markalvincadangin/smart-water-pump-controller/assets/smartflow-architecture-diagram.png

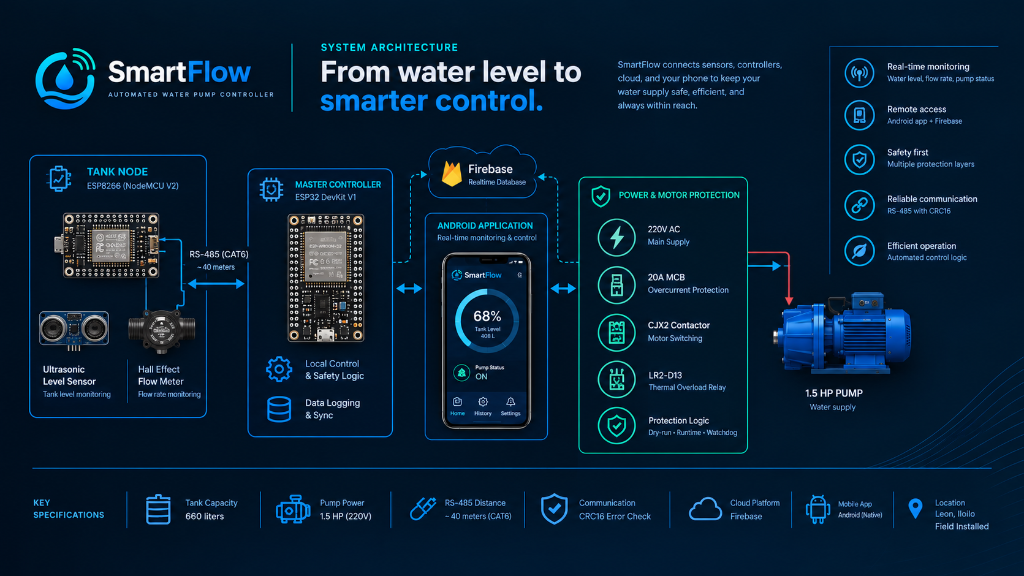
assets/smartflow-architecture-diagram.png
