markalvincadangin/smart-water-pump-controller/assets/smartflow-brandmark.png

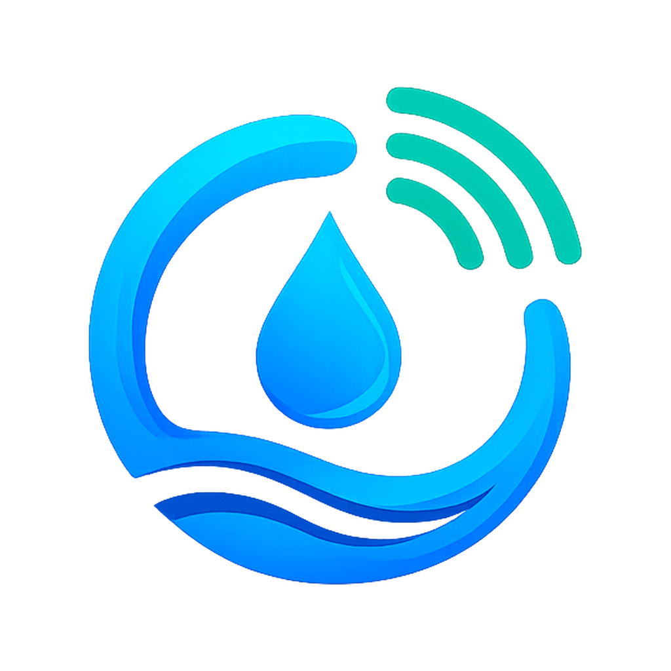
assets/smartflow-brandmark.png
