markalvincadangin/smart-water-pump-controller/assets/smartflow-hero-conceptual.jpg

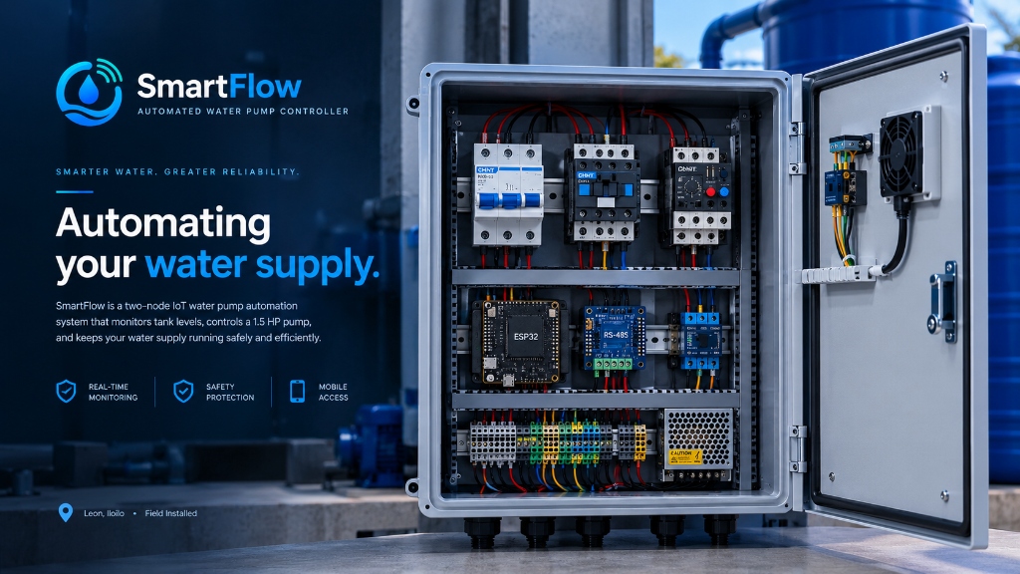
assets/smartflow-hero-conceptual.jpg
