markalvincadangin/smart-water-pump-controller/assets/smartflow-lockup-light.png

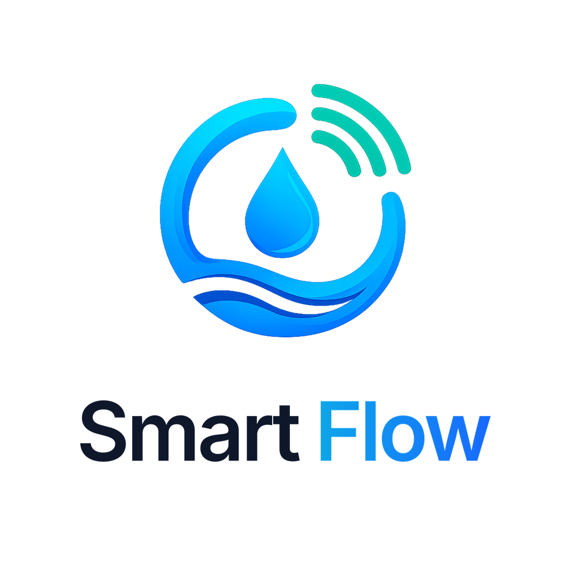
assets/smartflow-lockup-light.png
