markalvincadangin/smart-water-pump-controller/assets/smartflow-system-architecture.jpg

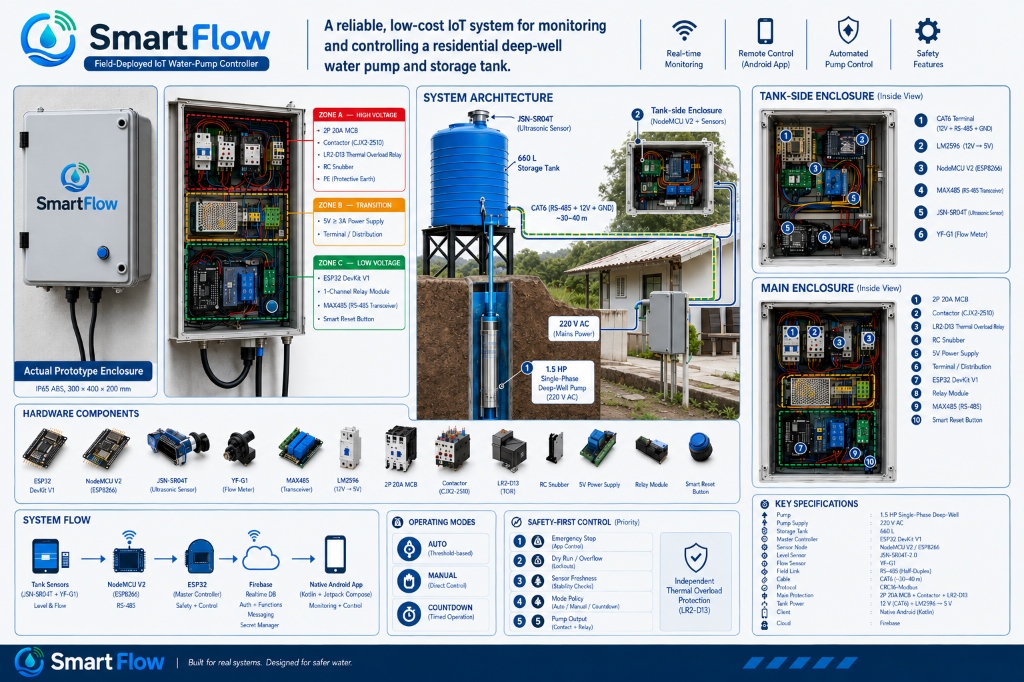
assets/smartflow-system-architecture.jpg
