markalvincadangin/smart-water-pump-controller/assets/smartflow-wordmark.png

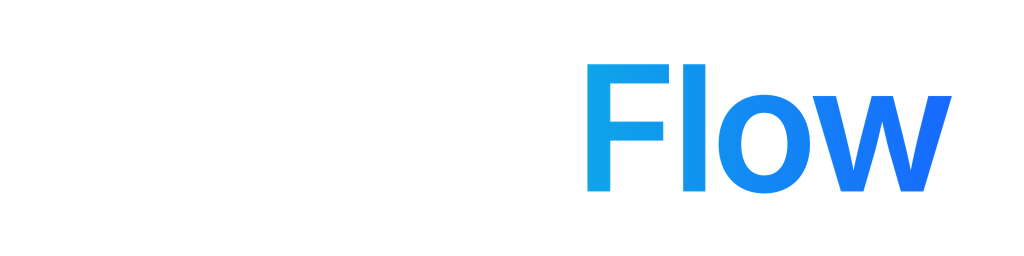
assets/smartflow-wordmark.png
