markalvincadangin/smart-water-pump-controller/docs/assets/portfolio/android-countdown-control.jpg

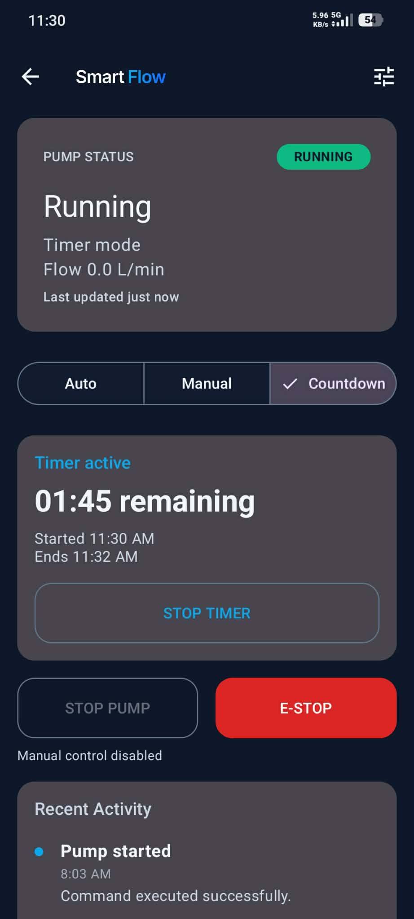
docs/assets/portfolio/android-countdown-control.jpg
