markalvincadangin/smart-water-pump-controller/docs/assets/portfolio/android-device-provisioning.jpg

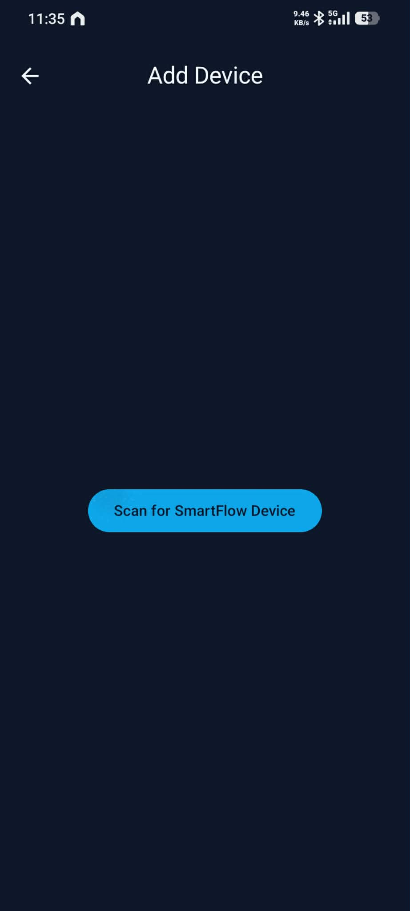
docs/assets/portfolio/android-device-provisioning.jpg
