markalvincadangin/smart-water-pump-controller/docs/assets/portfolio/prototype-enclosure.jpg

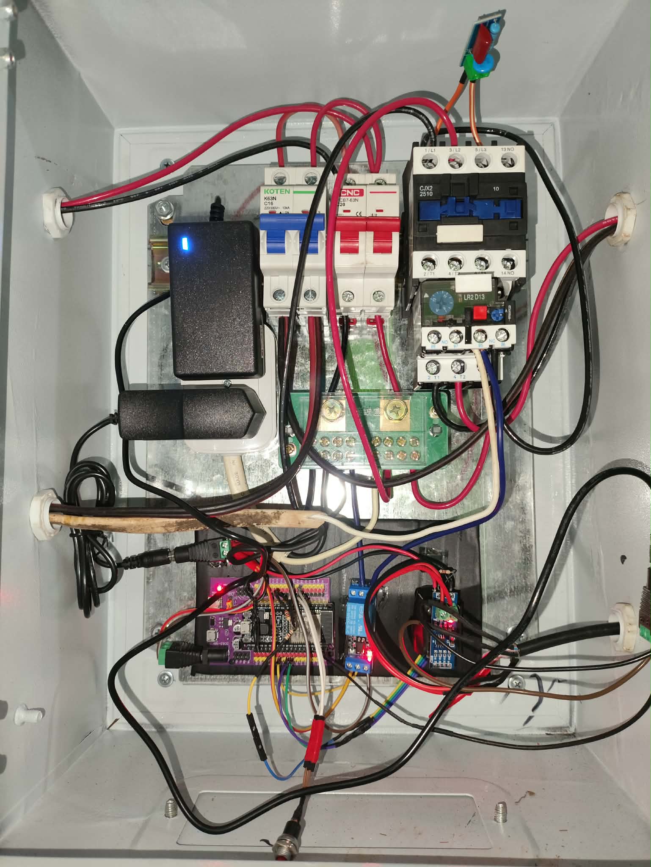
docs/assets/portfolio/prototype-enclosure.jpg
