markalvincadangin/smart-water-pump-controller/assets/smartflow-hardware-components.png

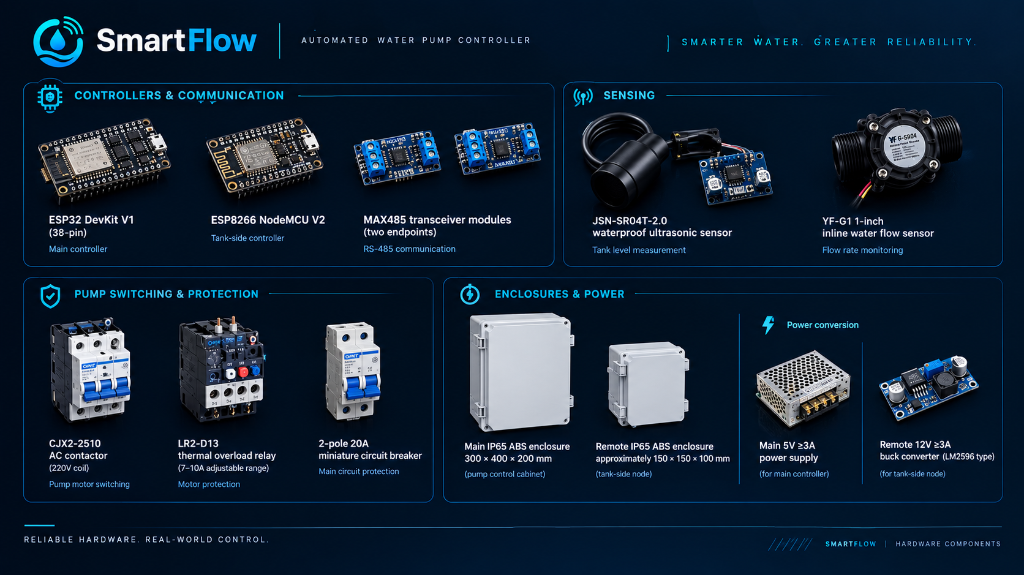
assets/smartflow-hardware-components.png
