markalvincadangin/smart-water-pump-controller/docs/specs/firmware_operational_rules.md

---
status: current
version: 1.0
last-reviewed: 2026-07-25
source: hand-authored
---

# SmartFlow Firmware Operational Rules (Current)

| Field | Value |
|---|---|
| Product | SmartFlow |
| Scope | `firmware/master_node/` (ESP32 master) |
| Status | Normative operational behavior |
| Last reviewed | 2026-07-25 |

For hardware architecture, build targets, RS-485 protocol, and RTDB schema see [`docs/specs/firmware.md`](./firmware.md).

This is the single source document for implemented firmware behavior: modes, safety, cloud connectivity, WiFi recovery, BLE provisioning, restart/safe-mode behavior, and command semantics.

## BLE Provisioning

An unprovisioned controller advertises a provisioning-only BLE service. It exposes one command characteristic (write and write-without-response) and one response characteristic (notify). The service is for onboarding and maintenance only; pump control remains on the cloud control path after provisioning.

- Commands and responses are JSON objects with protocol version `v: 1` and a request ID `id`.
- Supported commands are `scan_wifi`, `get_token`, `connect_wifi`, and `reset`. Malformed, unsupported, or concurrent requests produce structured error responses.
- Wi-Fi scanning emits `scan_start`, one or more `network` results (including BSSID, RSSI, and authentication mode), then `scan_complete`.
- `connect_wifi` persists the supplied credentials, starts association without blocking the BLE write callback, then emits `connecting`, `connected`, and `provisioned` only after association succeeds. Connection failures emit a `TIMEOUT` error after 20 seconds and leave the device available for retry.
- The `get_token` response includes the canonical cloud device identifier (`SF-…`). The Android app uses that identifier—not the opaque provisioning token—to claim the device in RTDB.
- On successful provisioning, the controller initializes cloud services and keeps BLE alive briefly so the final notification can be delivered before deinitializing BLE.

## Local Development OTA

The ESP32 master uses a dual-slot OTA partition table (`smartflow_ota.csv`) so an incoming development image is staged in the inactive application slot. The `esp32dev_ota` environment enables ArduinoOTA and accepts uploads on the local network after Wi-Fi is connected. A USB flash is required once when migrating an already-flashed device to this partition layout; subsequent development uploads use OTA.

## 1. Mode Model

- `pumpMode` is exclusive: exactly one policy mode at a time:
  - `AUTO`
  - `MANUAL`
  - `COUNTDOWN`
- MANUAL and COUNTDOWN cannot run concurrently.
- Certain mode transitions clear incompatible runtime state (for example, exiting active COUNTDOWN clears its timer state).
- Deprecated `FORCE_ON` and `FORCE_OFF` are mapped to `AUTO` for backward compatibility.

## 2. Decision Priority

Each loop effectively evaluates in this order:

1. Emergency stop latch
2. Hard safety lockouts (`DRY_RUN`, `OVERFLOW`)
3. Sensor freshness/stability gates
4. Mode policy logic (`MANUAL`, `COUNTDOWN`, `AUTO`)
5. Cloud and telemetry updates

Higher-priority OFF conditions always override lower-priority run intent.

## 3. Emergency Stop and Recovery

- `emergency_stop: true` is one-shot and immediate:
  - sets `emergency_stop_latched = true`
  - saves current mode for later restore
  - forces relay OFF
  - clears active countdown timer
- While latched:
  - mode apply is blocked
  - control processing continues for recovery commands (`reset_stop`, `clear_error`, bypass fields)
- `reset_stop: true`:
  - clears latch and restores saved mode
  - is blocked if hard lockout (`DRY_RUN` or `OVERFLOW`) is still active

## 4. Safety Rules (Mode-Independent)

- Safety always fails toward pump OFF.
- `is_error` (`DRY_RUN`) or `is_overflow_error` (`OVERFLOW`) forces pump OFF in all modes.
- Stale/unstable remote level data blocks starts and can stop running pump (unless bypass is enabled).
- Safety lockouts must be explicitly cleared (`clear_error`) before normal mode intent can drive ON again.

## 5. Mode-Specific Rules

### 5.1 Shared Gates (MANUAL & COUNTDOWN)

Both MANUAL and COUNTDOWN modes share a unified pre-evaluation block for safety:
- **Sensor Freshness**: Fresh/stable level data is required when level bypass is OFF. If freshness fails, the pump stops (failsafe) and active COUNTDOWN timers are aborted.
- **Tank Full**: Reaching the tank-full threshold (`pump_stop_level`) unconditionally stops the pump (and aborts active COUNTDOWN timers).
- **Min Off-Time**: Cooldown (`MIN_PUMP_OFF_TIME_MS`) is strictly enforced before any restart.

### 5.2 MANUAL

- Intent-based control:
  - `manual_desired = true` requests ON
  - `manual_desired = false` requests OFF
- Overflow policy is Option B:
  - `manual_runtime_warning` at ~90% runtime
  - hard overflow stop at configured max runtime

### 5.3 COUNTDOWN

- Runs only when:
  - `pumpMode == "COUNTDOWN"`
  - timer is active
- `countdown_start` is one-shot start.
- `countdown_add_time` is validated and capped extension.
- `countdown_stop` clears timer but keeps mode COUNTDOWN (idle).
- On expiry (or if interrupted by a shared safety gate):
  - `countdown_start` is force-cleared from Firebase `desired` state *before* turning the pump off. This acts as a software defense-in-depth against stale-state EMI crash loops (now primarily prevented via hardware RC snubber).
  - pump OFF
  - mode automatically reverts to `MANUAL` with `manual_desired = false` (MANUAL OFF). This is a strict safety fallback because AUTO mode relies on ultrasonic sensors which may not be fully stabilized yet in the physical deployment.

### 5.4 AUTO

- Start at/below `pump_start_level`.
- Stop at/above `pump_stop_level`.
- Min off-time enforced before restart.
- If level data is stale/unstable (and bypass OFF), AUTO start is blocked and running pump is stopped fail-safe.

## 6. Cooldown / Anti-Short-Cycle

- After OFF transition, minimum off-time is enforced before any restart.
- `run_mode` reflects cooldown:
  - `AUTO_COOLDOWN`
  - `MANUAL_COOLDOWN`

## 7. One-Shot Command Semantics

One-shot behavior (practical semantics):

- `emergency_stop`
- `reset_stop`
- `clear_error`
- `countdown_start`
- `countdown_stop`
- `countdown_add_time` (edge-detected extension command; firmware clears it when consumed)

These command paths are designed to avoid sticky replay during reconnect/retry windows.

## 8. Firebase Cloud Cycle Rules

- Cloud sync loop performs:
  1. control read (`/pump_system/control`)
  2. if control succeeds, status push (`/pump_system/status`)
- When cloud sync is due, RS-485 polling applies a short time budget so transport stalls do not starve Firebase updates.
- If control read fails, status push is skipped in that cycle to avoid compounding failures.
- Auth/timeouts increment dedicated counters and may trigger cooldown windows.
- Runtime telemetry includes connectivity health fields:
  - consecutive failures
  - timeout/auth counters
  - last error
  - per-call and per-cycle durations

## 9. WiFi Reconnection Rules

- Startup WiFi connect is bounded by retry count.
- Watchdog is registered before startup connect and fed in retry loop.
- Reconnect path uses backoff + jitter.
- On reconnect:
  - Firebase init/refresh logic executes
  - token refresh path runs
  - NTP resync attempted

## 10. Restart / Persistence / Safe Mode

- Crash-loop detection uses NVS boot counters.
- On threshold, safe mode is entered:
  - normal init path is constrained
  - pump remains fail-safe OFF behavior
  - auto-clear uses wall-clock when available, fallback timing otherwise
- On normal boot, stale `countdown_start` intents are cleared from the cloud shadow before pump logic evaluates. This serves as a software defense-in-depth against rapid-cycling loops in the event of an unexpected hardware brownout (e.g., if the contactor RC snubber fails).
- Persisted state includes core mode/config and runtime counters.
- Some runtime timers remain volatile across reboot (documented operational limitation).

## 11. Operational Invariants

- Pump must not remain ON when freshness/stability safety gate fails (with bypass OFF).
- Emergency stop must always de-energize and latch.
- No MANUAL+COUNTDOWN concurrent run path exists.
- Hard safety lockouts always dominate mode intent until cleared.
- Direct relay control is strictly evaluated inside `PumpApp::executeLogic()` (and `checkCountdownExpiry()`). The main loop acts as an orchestrator and never bypasses these safety constraints to drive the relay directly.
