markalvincadangin/smart-water-pump-controller/(commit log)

2026-03-05 Initial commit: Smart Water Pump Controller
2026-03-05 feat: per-user email notifications and functions node engine fix
    - Change notifications to be stored per user under notifications_by_user/{uid}
    - Update Cloud Function to fan out alerts to all enabled users with per-user throttling
    - Tighten RTDB rules so each user can only read/write their own config; keep throttles private
    - Wire dashboard to current user uid in notification settings and document new behavior
    - Set functions Node engine to 22 for Firebase deploy compatibility
    Made-with: Cursor
2026-03-08 feat: ENHANCEMENT_PLAN Phases 1-5, docs, dashboard fixes
    - Firmware: safety (overflow, sensor failure), resilience, sleep, config expansion, uptime
    - Dashboard: dynamic StatCard labels, optimistic config update, dryRunTimeoutSec, overflow alert
    - Cloud Functions: overflow protection email alert
    - Docs: DEPLOY_GUIDE, README, firmware README, NOTIFICATIONS, FIRMWARE_CONFIG
    - Board: Huge APP partition scheme for ~1.25MB firmware
    - Database rules: additional authorized UIDs
    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
2026-03-08 Phase 6: PWA, push notifications, tooltips, modal fixes, firmware updates
    - Dashboard: PWA (manifest, install prompt, icons), FCM push notifications
    - InfoTooltip: portal-based tooltips, fixed positioning and display
    - Settings modals: fixed footer overlap (Seed defaults), consistent section headers
    - DeviceConfigSettings & NotificationSettings: layout fixes, tooltips for all fields
    - Functions: FCM push support in Cloud Functions
    - Firmware: WDT compatibility (Arduino ESP32 2.x/3.x), libraries.txt update
    - Docs: FIREBASE_OPTIMIZATION, DEPLOY_GUIDE, ENHANCEMENT_PLAN, NOTIFICATIONS_SETUP
    - .gitignore: tsconfig.tsbuildinfo, *.resolved
    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
2026-03-09 Refine dashboard UX, roles, and validation tooling
    Align admin handling with RTDB admins map, clean up role-based views and typography, improve empty states and notification thresholds, simplify favicon usage, and wire Lighthouse CI to validate the built Next.js app via npm start.
    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
2026-03-13 Implement smart runs and harden weak WiFi behavior
    - Add Phase 7 manual/timed run controls end-to-end (firmware + dashboard) with safer FORCE_ON UX and clear separation of policy vs run mode.
    - Harden Firebase/cloud handling and dashboard timers for unstable WiFi so safety logic keeps running, commands are edge-triggered, and UI remains responsive.
    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
    [smart_water_pump_controller_shared.h]
2026-03-14 v3.0.0: Firmware + dashboard v3 spec, docs restructure, formatting fixes
    Firmware:
    - Bump version to 3.0.0 (both Arduino and PlatformIO builds)
    - Hierarchical priority model (P1–P5), COUNTDOWN, manual_start/stop
    - Level sensor bypass, auto-bypass, run_mode, fault codes, telemetry
    Dashboard:
    - Mobile-first layout, CollapsibleSection for Layer 4, DashboardSkeleton
    - RunControls/ModeControls v2.0 UX, OverflowMenu, alert actions
    - usePumpData/useDeviceConfig/audit aligned with v3 spec
    Docs:
    - Restructure: releases/v2.0, releases/v3.0, operations, archive, assets
    - Fix literal \\n escape sequences and RS485 code block closing
    .gitignore: add .cursor/
    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
    [smart_water_pump_controller_shared.h]
2026-03-15 feat(prod): official v3.0 release - certified zero-failure launch
    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
    [smart_water_pump_controller_shared.h]
2026-03-15 Countdown add-time, mode write-back after lockout, dashboard mode sync
    - Firmware: process countdown_add_time when pumpMode==COUNTDOWN; only extend timer when countdown actually running (no re-activate on lockout)
    - Firmware: immediate mode write-back to Firebase when pending (e.g. after dry-run lockout) so dashboard shows AUTO; 5s throttle only for retries
    - Dashboard: preserve control in snapshot on status updates so mode is not overwritten by stale controlRef (fix mode stuck on COUNTDOWN after lockout)
    - Dashboard: show Add time when runMode or controlMode is COUNTDOWN; 20s fallback for countdown_add_time reset; custom duration/add-time support
    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
2026-03-17 Implement mode architecture v5 and align docs
    - Add sticky MANUAL_OFF behavior and safety/override edge-case fixes in firmware (Arduino + PlatformIO)
    - Update dashboard controls/alerts/history for v5 UX (MANUAL toggle, action-first countdown, FORCE_ON nav)
    - Refresh README/spec docs to match current firmware/dashboard
    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
    [smart_water_pump_controller_shared.h]
2026-03-24 Dashboard: SmartFlow design system polish, logos, and minimalist UI cleanup
    - Align tokens/layout with smartflow_design_system_spec (grid, flow strip, tank glass)
    - Geist + next/font; theme storage smartflow-theme; Tailwind darkMode selector
    - SVG brand assets (logos); remove legacy PWA PNG icons; update manifest/FCM/metadata
    - Mode radiogroup, emergency stop consolidation, StatCard/toast/history/login polish
    - Remove dead StatCard glow map entries; add implementation_plan + design spec docs
    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
2026-04-01 Add SmartFlow NodeMCU V2 Hardware Test Suite and migration scripts
    - Introduced a comprehensive hardware test suite for the NodeMCU V2, including tests for hardware sanity, ultrasonic sensor, flow sensor, RS-485 communication, and CRC validation.
    - Created a README.md file detailing the test cases, expected outputs, and troubleshooting steps.
    - Implemented a Python script to migrate logging statements from Serial to a new logging format for both the smart water pump controller and sensor node.
    - Added a PowerShell script to capture baseline metadata for QA traceability before execution, including git commit hashes for firmware and dashboard.
2026-04-01 Enhance RS-485 communication tests and documentation
    - Updated WAVE_A_EXECUTION_REPORT.md to reflect hardware visibility changes and test outcomes for ESP32 and NodeMCU.
    - Added detailed execution logs for ESP32-first and NodeMCU standalone runs.
    - Revised evidence_index.csv to include new log artifacts from recent tests.
    - Expanded README.md in test_master_node to include a new RS-485 Hello Handshake test (TC-M-00) and updated test procedures.
    - Implemented RS-485 Hello Handshake functionality in test_master_node.ino for initial communication validation.
    - Improved RS-485 Slave Echo Server functionality in test_sensor_node.ino, renaming it to RS-485 Slave Responder and enhancing command han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
2026-04-01 Increase RS-485 frame timeout and enhance command payload structure
2026-04-01 Enhance RS-485 responder functionality and improve ultrasonic flow sensor tests
2026-04-04 feat: SmartFlow water level calibration fix - complete solution
    Root cause: RTDB device config missing tank_empty_cm and tank_full_cm fields
    caused ESP32 to use wrong hardcoded calibration (122/8 cm) instead of field
    values (120/30 cm), resulting in level showing 45% when actual is 55%.
    Solution: Add calibration fields to RTDB /pump_system/config/device
    Deliverables:
    - scripts/diagnose-and-fix-calibration.js: Comprehensive diagnostic + auto-fix
    - scripts/test-calibration-fix.js: End-to-end verification and formula testing
    - scripts/fix-device-config-calibration.js: Simple update utility
    Documentation:
    - docs/operations/QUICKSTART_CALIBRATION_FIX.md: 1-page deployment guide
    - docs/operatio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
2026-04-04 docs: polish documentation and standardize file naming
    - Fixed README.md: corrected broken links (firebase_schema.md → README.md, TROUBLESHOOTING → troubleshooting.md)
    - Updated acknowledgments to reflect accurate authorship (user as sole creator, AI-assisted)
    - Removed incorrect license/security references
    - Standardized calibration documentation file names to lowercase for consistency with project conventions:
    - CALIBRATION_FIX_DELIVERY_MANIFEST.md → calibration_fix_delivery_manifest.md
    - CALIBRATION_FIX_INTEGRATION.md → calibration_fix_integration.md
    - CALIBRATION_FIX_TASK_COMPLETION_REPORT.md → calibration_fix_task_completion_report.md
    - CALIBRATION_FIX_VERIFICATION_CHE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
    [config.h, main.cpp]
2026-04-04 fix: address PR review comments on rules, timer, and docs
2026-04-04 fix(dashboard): stabilize countdown interpolation and sensor defaults
2026-04-04 fix(firmware): harden rs485 response timing and level fallback
    [config.h, rs485_comm.cpp, rs485_slave.cpp]
2026-04-04 docs(safety): clarify MCB isolation vs relay functional test
2026-04-04 fix: publish pending dashboard auth and firmware updates
    [rs485_comm.cpp]
2026-04-04 fix(dashboard): avoid false sensor comm alert during initial load
2026-07-25 docs: archive historical QA, releases, and UPPERCASE duplicate calibration files
    Step D of documentation standardization:
    - Archive 59 historical/scratch files to docs/archive/2026-07/
    - All 7 UPPERCASE calibration files confirmed identical content (LF vs CRLF only)
    to their lowercase canonical counterparts — safely archived
    - QA execution logs (Wave 0: 2026-03-31, Wave A: 2026-04-01) archived
    - Release v1.0.0 snapshot docs archived
    - HTML audit export artifacts (3 files) archived
    - Removed orphan docs/01_specs/ (mistaken Step C draft)
    Live docs tree now: docs/specs/, docs/operations/, docs/audit/firmware_known_issues,
    docs/plans/, docs/assets/, docs/archive/2026-07/ (historical, preser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
2026-07-25 docs(specs): add GPIO hardware interface table to firmware.md; track S-13
    firmware.md:
    - Add "Hardware interface (GPIO assignments)" section between Firmware
    build targets and RS-485 tank link
    - ESP32 master table: RELAY_PIN/GPIO4, RS485_TX_PIN/GPIO17,
    RS485_RX_PIN/GPIO25, RS485_DE_RE_PIN/GPIO5 — sourced from config.h
    - NodeMCU V2 table: PIN_RS485_DE_RE/GPIO14, PIN_FLOW_INPUT/GPIO12,
    PIN_US_TRIG/GPIO5, PIN_US_ECHO/GPIO16 — sourced from config.h
    - PIN_FLOW_INPUT carries verbatim "temporary diagnostic reroute" annotation
    - PIN_US_ECHO level-shift note omitted from table (not in config.h);
    footnote points to existing "Hardware assumptions" section where it lives
    - UART0 pins (GPIO1/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
2026-07-25 chore: stage remaining untracked tooling and operations files
    docs/operations/ — 7 canonical lowercase calibration runbooks that were
    already present on disk but never git-tracked (the UPPERCASE duplicates
    were archived in Step D; these are the originals being added now):
    calibration_fix_delivery_manifest.md
    calibration_fix_integration.md
    calibration_fix_task_completion_report.md
    calibration_fix_verification_checklist.md
    level_calibration_fix.md
    quickstart_calibration_fix.md
    water_level_calibration_fix_complete.md
    Brownfield extension integration files (auto-generated by specify
    extension add during tooling setup):
    .agents/skills/speckit-brownfield-{bootstrap,migrate,scan,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
2026-07-25 chore: unify platformio firmware directories and cleanup stale Arduino rules
2026-07-27 feat(firmware): extract app layer from safety orchestrator
    Extract mode-awareness (MANUAL, COUNTDOWN, AUTO) from safety_pump.cpp into a centralized app/pump_app.cpp orchestrator.
    checkSafetyCutoff() and checkOverflowProtection() now act purely as factual safety guards, returning status structs that the app layer acts upon.
    Single-Caller Exception:
    Direct relay control (setPump) is strictly limited to app_executePumpLogic(), with one deliberate exception: the emergency_stop handler in connectivity_cloud.cpp retains its direct setPump(false) call. This prevents a critical 60-second latency bug during idle/sleep modes by bypassing the periodic orchestrator loop. Documented in firmware_operati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
    [main.cpp]
2026-07-27 feat(003): Complete Commercial IoT Architecture — Epic 2 (Cloud) + Epic 3 (Android)
    Epic 2 — Firmware Cloud Integration:
    - Refactor firmware to strict 5-layer architecture (hal/drivers/network/cloud/safety/app)
    - Add UNCLAIMED/PROVISIONING/ONLINE lifecycle states to state machine
    - Implement WifiManager with auto-reconnect and RSSI tracking
    - Implement BleProvisioning using NimBLE; exposes GATT SSID/Pass/Token/Commit
    - Generate cryptographic claim token (esp_random) on first boot; exposed via READ characteristic
    - Implement DeviceShadow (desired vs reported) with safety-gated delta evaluation
    - Implement CloudManager syncing to /devices/<id>/{metadata,status,telemetry,shadow,diagnostics,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
2026-07-28 feat(app): implement UI/UX countdown and overrides, wire up Firebase repo, apply Stitch logo, update firmware shadow mapping
2026-07-28 fix(integration): use immutable state for RTDB updates and bypass sensors
2026-07-28 feat(provisioning): secure ownership recovery checkpoint
    [smartflow_ota.csv]
